God-of-Hacker/uC_Board/BOM/materialliste_microcontroller_board.xlsx

Sheet: Stückliste
Bemerkung | Pos | Bezug | Stk/Board | Bezeichnung | Typ/Wert | Gehäuse | Lieferant | Artikel-Nr | Link | Preis/Stk | Preis/Board | Stk für 35 | Preis für 35 | Status (ok) | Bestand (17.09.2021)
 |  |  | 1 | Schmitt_Tirgger | Logic-IC SO-14, 74HC14D, NXP | SO-14 | mouser | 771-74HC14D-Q100 |  | 0.320 | 0.32 | 35 | 11.20 |  | 34
 |  |  | 1 | Mikrocontroller | ATMEGA2560-16AU | TQFP-100 | digikey | ATMEGA2560-16AU-ND |  | 16.570 | 16.57 | 35 | 579.95 |  | 10
 |  |  | 1 | 74HC138 3 to 8 Decoder | Texas | TSSOP-16 | Mouser | 771-74HC138D-Q100 |  | 0.455 | 0.46 | 35 | 15.93 |  | 35
 |  |  | 1 | Induktivität | 10uH | 1206 | Mouser | 815-AIML-1206-100KT |  | 0.071 | 0.07 | 35 | 2.48 |  | 45
 |  |  | 1 | Quarz | 16MHz | HC49 | Mouser | 695-HCM49-16MABKUT |  | 0.460 | 0.46 | 35 | 16.10 |  | 37
 |  |  | 1 | LCD 4x40 Zeichen | EADIP203-4 |  | Mouser | 790-EADIP203J-4NLW |  | 32.830 | 32.83 | 35 | 1149.05 |  | 36
 |  |  | 1 | USB-C Kabel | Red, 1m |  | AliExpress |  | https://www.aliexpress.com/item/33002369577.html?spm=a2g0o.cart.0.0.38133c002f24TT&mp=1 | 1.720 | 1.72 | 35 | 60.20 |  | 50
 |  |  | 1 | USB-C Buchse | 10 x USB-C, 6Pin |  | AliExpress |  | https://www.aliexpress.com/item/4000857925361.html | 1.299 | 1.30 | 35 | 45.47 |  | 82
 |  |  | 1 | J-Tag-Buchse | Header VERT 10POS 1.27MM |  | digikey | 1175-1627-ND | https://www.digikey.ch/product-detail/de/cnc-tech/3220-10-0100-00/1175-1627-ND/3883661?cur=CHF&lang=de | 0.530 | 0.53 | 35 | 18.55 |  | 128
 |  |  | 1 | Lichtsensor | SFH 5701 |  | Mouser | 720-SFH5701 |  | 0.615 | 0.61 | 35 | 21.52 |  | 39
 |  |  | 1 | LED Diffusor | Abdeckung RGB LED |  | Farnell | 1215771 |  | 2.240 | 2.24 | 35 | 78.40 |  | 31
 |  |  | 1 | Spannungsregler 3.3V | XC6220B331MR-G | SOT-25 | Farnell | 1830935 |  | 0.782 | 0.78 | 35 | 27.37 |  | 12
 |  |  | 1 | Potentiometer | 3314G-1-252E / 2k5 | 3314G | Farnell | 2328470 |  | 0.934 | 0.93 | 35 | 32.69 |  | 43
nicht bestücken |  |  | 0 | Anschlussblock Phönix | 2Pol | 3.81mm | Farnell | 3704725 |  | 0.702 |  | 0 |  |  | ok
nicht bestücken |  |  | 0 | Schraub-Steckklemme Phönix | 2Pol | 3.81mm | Farnell | 3704907 |  | 2.600 |  | 0 |  |  | ok
 |  |  | 1 | 2x7 Stiftwanne 2514 | 3M | 2,54mm | Mouser | 517-30314-6002 |  | 1.210 | 1.21 | 35 | 42.35 |  | 42
 |  |  | 1 | Jumper | Jumper | 2.54mm | Mouser | 571-1-881545-4 |  | 0.050 | 0.05 | 35 | 1.75 |  | 460
 |  |  | 1 | LED | Grün | 1206 | Mouser | 604-APL3015CGCK-F01 |  | 0.130 | 0.13 | 35 | 4.55 |  | 41
 |  |  | 1 | Potentiometer | 50k |  | Mouser | 81-PVG3G503C01R00 |  | 1.620 | 1.62 | 35 | 56.70 |  | 3
 |  |  | 1 | Quarz | 32.768kHz | 3.2x8.3mm | Mouser | 815-AB38T-32.768KHZ |  | 0.156 | 0.16 | 35 | 5.46 |  | 52
 |  |  | 1 | Temperatursensor LM35DZ | TO-92 | 1,27mm | Mouser | 926-LM35DZ/NOPB |  | 0.749 | 0.75 | 35 | 26.21 |  | 24
 |  |  | 1 | LED | RGB | PLCC6 | Farnell | LEDCLX6E-FKC-CH1M1D1BB7C3D3 |  | 0.364 | 0.36 | 35 | 12.74 |  | 56
 |  |  | 1 | Joystick | Yellow (new) version |  | AliExpress |  | https://www.aliexpress.com/item/32641145656.html?spm=a2g0s.9042311.0.0.1a2c4c4dHblPEt | 1.760 | 1.76 | 35 | 61.60 |  | 14
 |  |  | 2 | Sicherung | ERB-RG2R00V | 1206 | Mouser | 667-ERB-RG2R00V |  | 0.475 | 0.95 | 70 | 33.25 |  | 54
 |  |  | 2 | 9P Header für LCD Display | 1x9 Pin SMD | 2mm | Mouser | 200-MMS10902FSV |  | 2.100 | 4.20 | 70 | 147.00 |  | 23
 |  |  | 3 | 2x5 Stiftwanne 2510 | 3M | 2,54mm | Mouser | 517-30310-6002 |  | 0.619 | 1.86 | 105 | 65.00 |  | 51
 |  |  | 2 | Potentiometer | 10kOhm | PTV09A | Mouser | 652-PTV09A-4020UB103 |  | 0.720 | 1.44 | 70 | 50.40 |  | 63
 |  |  | 2 | Widerstand | 10kΩ | 0805 | Mouser | 279-CRG0805F10K/10 |  | 0.027 | 0.05 | 70 | 1.89 |  | 830
 |  |  | 2 | Widerstand | 2kΩ | 0805 | Mouser | 652-CR0805JW-202ELF |  | 0.031 | 0.06 | 70 | 2.17 |  | 104
 |  |  | 2 | Keramikkondensator | 12pF 50V | 0805 | Mouser | 77-VJ0805A120GXAPBC |  | 0.015 | 0.03 | 70 | 1.05 |  | 39
 |  |  | 2 | Keramikkondensator | 18pF 25V | 0805 | Mouser | 77-VJ0805A180GXXCBC |  | 0.029 | 0.06 | 70 | 2.03 |  | 59
 |  |  | 2 | Hallsensor SS39E | Honeywell | SOT-23 | Mouser | 785-SS39ET |  | 1.210 | 2.42 | 70 | 84.70 |  | 30
 |  |  | 3 | Elektrolytkondensator | 100uF 16V | 6.3 x 5.4 | Mouser | 710-865230245004 |  | 0.223 | 0.67 | 105 | 23.42 |  | 98
 |  |  | 3 | Widerstand | 1kΩ | 0805 | Mouser | 667-ERJ-UP6F1001V |  | 0.010 | 0.03 | 105 | 1.05 |  | 870
 |  |  | 3 | Keramikkondensator | 1uF 50V | 0805 | Mouser | 80-C0805X105K5RAUTO |  | 0.040 | 0.12 | 105 | 4.20 |  | 92
 |  |  | 4 | Gummifuss transparent VPE20 | 20er Packung | 9,5x3,8mm | Distrelec | 300-97-569 |  | 0.105 | 0.42 | 140 | 14.70 |  | 200
 |  |  | 4 | Taster | FSM4JSMA | 5mm | Farnell | 3801305 |  | 0.128 | 0.51 | 140 | 17.92 |  | 124
 |  |  | 4 | Stiftleiste | 1x36 Breakaway | 2.54mm | Mouser | 538-22-28-4360 |  | 0.045 | 0.18 | 140 | 6.30 |  | 570
 |  |  | 20 | FET N-Kanal 30V, 7.6A, 17mΩ | PMV20EN | SOT-23 | Mouser | 621-DMG3406L-13 |  | 0.088 | 1.76 | 700 | 61.60 |  | 390
 |  |  | 8 | FET P-Kanal 20V, 5.6A, 27mΩ | PMV27UPER | SOT-23 | Mouser | 771-PMV27UPER |  | 0.138 | 1.10 | 280 | 38.64 |  | 270
 |  |  | 8 | Schalter | 10 x 5mm Miniature |  | AliExpress |  | https://www.aliexpress.com/item/1887673102.html?spm=a2g0o.cart.0.0.38133c002f24TT&mp=1 | 0.648 | 5.18 | 280 | 181.44 |  | 230
 |  |  | 6 | Widerstand | 100kΩ | 0805 | Mouser | 652-CHV0805AFX1003LF |  | 0.010 | 0.06 | 210 | 2.10 |  | 450
 |  |  | 16 | Keramikkondensator | 100nF 50V | 0805 | Mouser | 80-C0805R104J5RACTU |  | 0.017 | 0.27 | 560 | 9.52 |  | 460
 |  |  | 16 | LED | Blau | 1206 | Mouser | 604-APT3216QBC/D |  | 0.156 | 2.50 | 560 | 87.36 |  | 250
 |  |  | 20 | Widerstand | 150Ω | 0805 | Mouser | 755-KTR10EZPJ151 |  | 0.011 | 0.22 | 700 | 7.70 |  | 390
Nicht Bestellen Klassensatz |  |  | 1 | Programmer | Atmel-Ice-Pcba | none | Farnell | 2407171 | https://ch.farnell.com/microchip/atatmel-ice-pcba/debugger-atmel-arm-avr-pcba-kit/dp/2407171 | 55.640 | 55.64 | 35 | 1947.40 |  | ok
Nicht Bestellen Klassensatz |  |  | 2 | Jtag stecker | CONN SOCKET 10POS IDC GOLD |  | digikey | 3230-10-0102-00 | https://www.digikey.ch/product-detail/de/3230-10-0102-00/3230-10-0102-00-ND/3883464/?itemSeq=343224426 | 0.690 | 1.38 | 70 | 48.30 |  | ok
Nicht Bestellen Klassensatz |  |  | 1 | Jtag Kabel ca 10 cm | FLAT RBN CBL GRAY 10 COND 100' |  | digikey | CN211GR-100-ND | https://www.digikey.ch/products/de?keywords=cn211gr-100 | 0.107 | 0.11 | 35 | 3.75 |  | ok
Nicht Bestellen Klassensatz |  |  | 1 | Micro-USB für Jtag | RND 765-00054 - USB-A Micro-B |  | Distrelec | 301-25-772 | https://www.distrelec.ch/de/usb-anschluss-auf-usb-micro-anschlusskabel-900mm-schwarz-rnd-connect-rnd-765-00054/p/30125772 | 1.240 | 1.24 | 35 | 43.40 |  | ok
 |  |  | 0.5 | Linieal Footprints… | PCB-RULER-ND |  | digikey |  |  |  |  | 17.5 |  |  | 0

Sheet: Anzahl & Preis
Anzahl Boards: | 35
Preis ein Board: | 147.33
Preis 35 Boards: | 5156.55

Sheet: Altes
Bemerkung | Pos | Bezug | Stk/Board | Bezeichnung | Typ/Wert | Gehäuse | Lieferant | Artikel-Nr | Link | Preis/Stk | Preis/Board | Stk für 35 | Preis für 35 | Status (ok)
nicht bestellen |  |  | 0 | Sicherung | MC12CT 002 / 2,0A | 1206 | Farnell | 1841062 |  | 0.226 |  | 0
nicht bestellen |  |  | 0 | 9P Header für LCD Display | 1x9 Pin SMD | 2mm | Mouser | 517-953109-2000-AR-PR |  | 2.510 |  | 0
Nicht bestücken |  |  | 0 | MICRO USB 2.0 BUCHSE | MOLEX 47589-0001 | TYP AB | Farnell | 1568023 |  | 0.662 |  | 0
nicht bestellen |  |  | 0 | Speisgerät 5V Micro USB | 5V / 2.5A 1.5m Kabel |  | Farnell | 2520785 |  | 9.330 |  | 0
nicht bestücken |  |  | 0 | DIP Switch 8x, 21.2x6.2 | 8 fach DIP Switch, 2.54mm | DIP-16 | Mouser | 642-DMR08T |  | 1.020 |  | 0
nicht bestellen |  |  | 0 | JTAG Stiftwanne | 10pol. 2x5 pin | 1.27mm | Mouser | 855-M50-3500542 |  | 0.895 |  | 0
nicht Bestellen |  |  | 0 | XY Joystick |  |  |  |  | www.parallax.com/product/27800 | 6.500 |  | 0
nicht Bestellen |  |  | 0 | LED | red | 1206 | Mouser | 604-APT3216SRCPRV |  | 0.075 |  | 0
nicht Bestellen |  |  | 0 | Schieberegister |  | So-16 | Mouser | 771-HC165D652 |  | 0.194 |  | 0
nicht Bestellen |  |  | 0 | Weisse LED | 150mcd, 3.3V, 20mA | 1206 | Distrelec | 634021 |  | 0.368 |  | 0
nicht Bestellen |  |  | 0 | DC/DCKonverter 5VDC 1A, Traco Power | TSR 1-2450 |  | Distrelec | 361662 |  | 5.500 |  | 0
- |  |  | 1 | Quarz | 16MHz | HC49 | Mouser | 520-CSM1600-20-X |  | 0.295 | 0.29 | 35 | 10.32
- |  |  | 3 | Elektrolytkondensator | 100uF 35V | 6.3 x 5.4 | Mouser | 647-UWT1V101MCL1S |  | 0.125 | 0.38 | 105 | 13.12 | 20, 150 bestellt
- |  |  | 20 | Widerstand | 150Ω | 1206 | Mouser | 71-CRCW1206150RFKEB |  | 0.010 | 0.20 | 700 | 7.00
- |  |  | 1 | Lichtsensor | ALS-PT17-51C/L177/TR8 |  | Distrelec | 632917 |  | 0.879 | 0.88 | 35 | 30.77 | 20, 50 bestellt
- |  |  | 4 | FET N-Kanal 30V, 7.6A, 17mΩ | PMV20EN | SOT-23 | Mouser | 771-PMV20ENR |  | 0.108 | 0.43 | 140 | 15.12
- |  |  | 1 | Mikrocontroller | ATMEGA2560-16AU | TQFP-100 | Mouser | 556-ATMEGA2560-16AU |  | 16.570 | 16.57 | 35 | 579.95
- |  |  | 1 | Schmitt_Tirgger | Logic-IC SO-14, 74HC14D, NXP | SO-14 | Distrelec | 17390099 |  | 0.320 | 0.32 | 35 | 11.20 | 10, 50 bestellt
- |  |  | 1 | Potentiometer | 3314G-1-503E / 50k | 3314G | Mouser | 652-3314G-1-503E |  | 1.620 | 1.62 | 35 | 56.70 | 20, 50 bestellt
 |  |  | 1 | LED | RGB | PLCC6 | Mouser | 941-X6AFKBCJNNRFJ7A3 |  | 0.364 | 0.36 | 35 | 12.74 |  | 56

Sheet: Halbleiterbezug
Stk/Board | Bezeichnung | Typ/Wert | Name 1 | Name 2 | Name 3 | Name 4 | Name 5 | Name 6 | Name 7 | Name 8 | Name 9 | Name 10 | Name 11 | Name 12 | Name 13 | Name 14 | Name 15 | Name 16 | Name 17 | Name 18
1 | Schmitt_Tirgger | Logic-IC SO-14, 74HC14D, NXP
1 | Mikrocontroller | ATMEGA2560-16AU
1 | 74HC138 3 to 8 Decoder | Texas
1 | Quarz | 16MHz
1 | LCD 4x40 Zeichen | EADIP203-4
1 | Lichtsensor | SFH 5701
1 | Spannungsregler 3.3V | XC6220B331MR-G
1 | LED | Grün
1 | Quarz | 32.768kHz
1 | Temperatursensor LM35DZ | TO-92
1 | LED | RGB
2 | Hallsensor SS39E | Honeywell
20 | FET N-Kanal 30V, 7.6A, 17mΩ | PMV20EN
8 | FET P-Kanal 20V, 5.6A, 27mΩ | PMV27UPER
16 | LED | Blau
1 | PCB
58 | Total |  | 0 | 0 | 0 | 0 | 0 | 0 | 0 | 0 | 0 | 0 | 0 | 0 | 0 | 0 | 0 | 0 | 0 | 0
Zeit Board 1
Zeit Board 1
Zeit Board 1 | Total |  | 0 | 0 | 0 | 0 | 0 | 0 | 0 | 0 | 0 | 0 | 0 | 0 | 0 | 0 | 0 | 0 | 0 | 0
Zeit Board 2
Zeit Board 2
Zeit Board 2 | Total |  | 0 | 0 | 0 | 0 | 0 | 0 | 0 | 0 | 0 | 0 | 0 | 0 | 0 | 0 | 0 | 0 | 0 | 0
