God-of-Hacker/uC_Board/Hardware/Vorlage ATmega2560-16AU/Vorlage ATmega2560-16AU.brd

## EAGLE design Hardware/Vorlage ATmega2560-16AU/Vorlage ATmega2560-16AU.brd (2021-11-11)

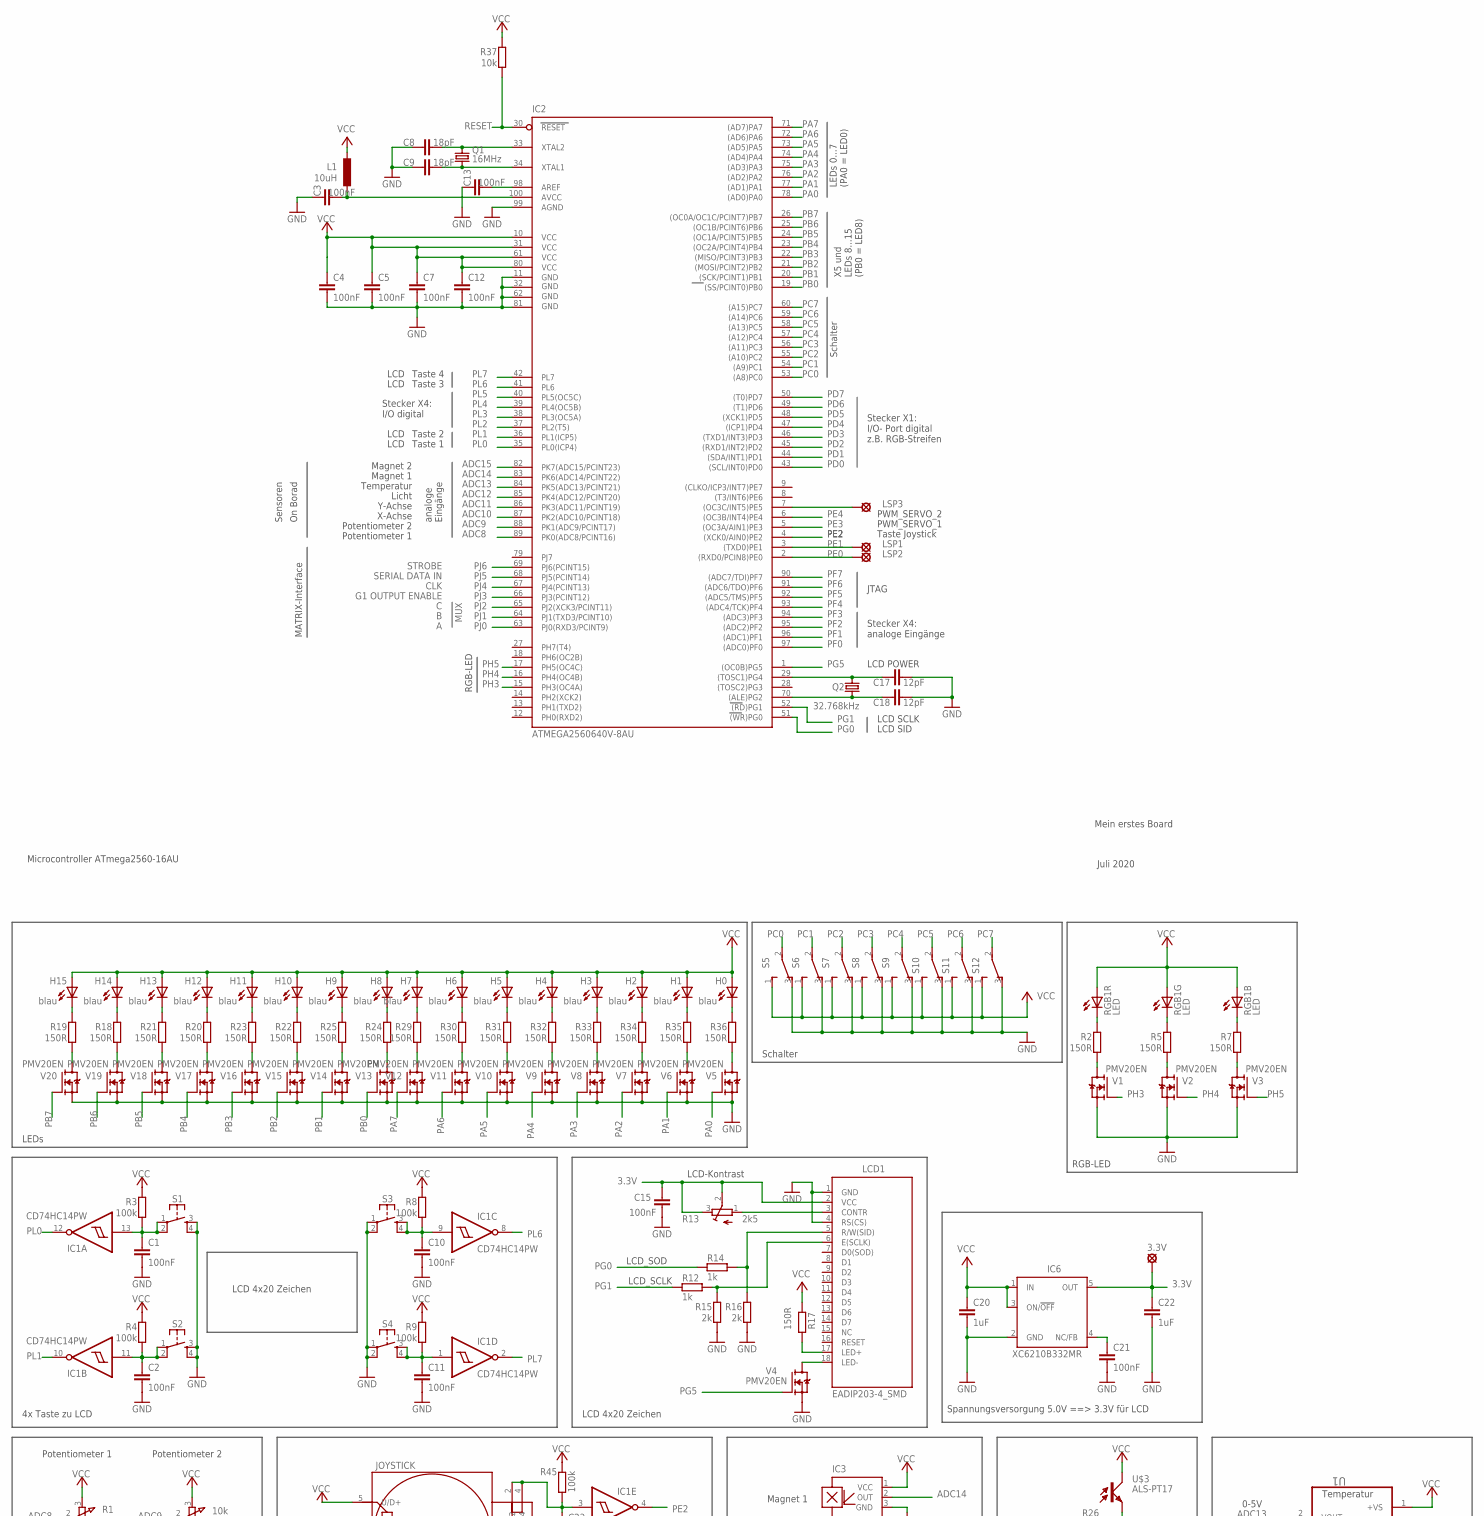
[picture p1: schematic Vorlage ATmega2560-16AU.sch, part in row 1, column 1]

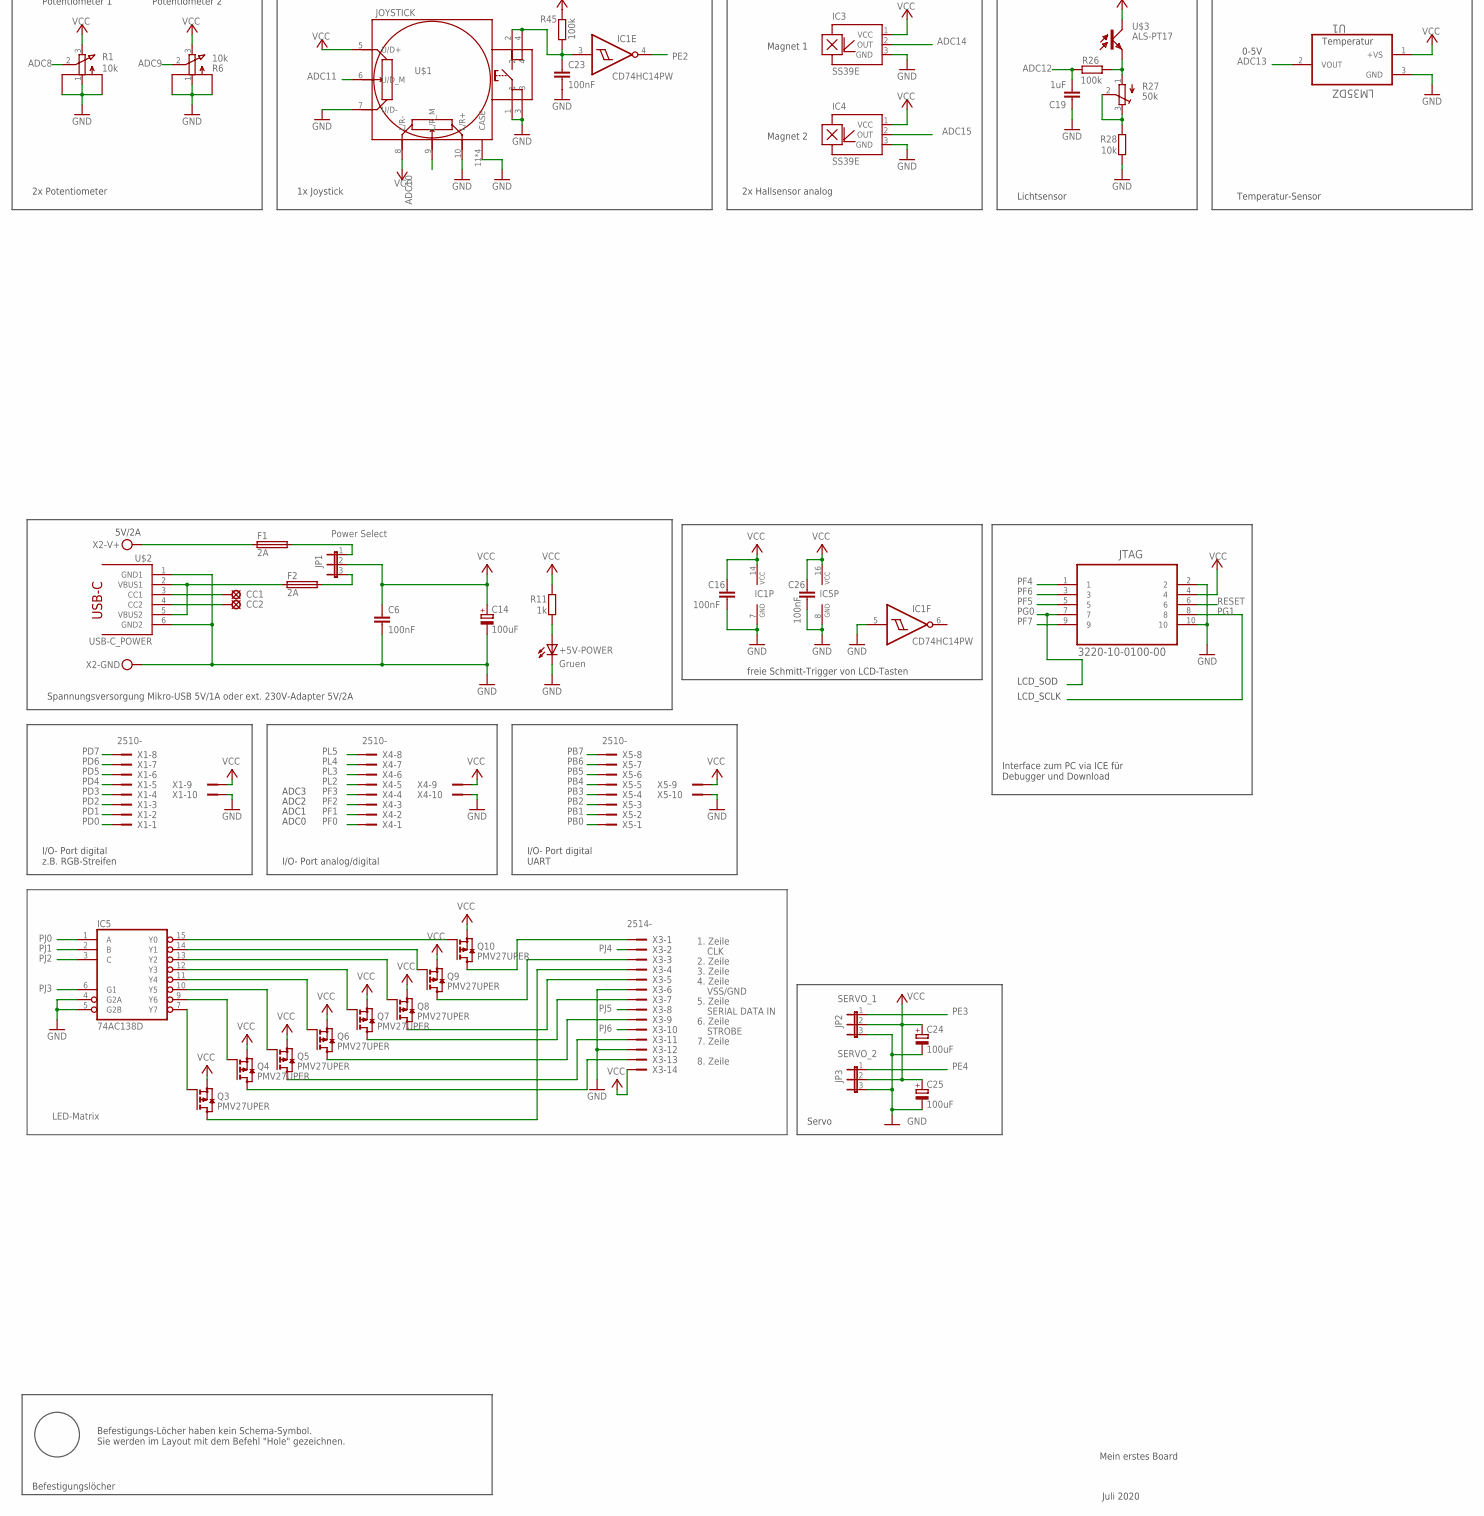
[picture p2: schematic Vorlage ATmega2560-16AU.sch, part in row 2, column 1]

Parts:
3.3V: 3.3V; LSP11
+5V-POWER: Gruen; CHIPLED_1206
C1, C2, C3, C4, C5, C7, C10, C11, C12, C13, C21, C23: 100nF; C0805
C6, C15, C16, C26: 100nF; C1206
C8, C9: 18pF; C0805K
C14, C24, C25: 100uF; UD-6,3X5,8_NICHICON
C17, C18: 12pF; C0805K
C19, C20, C22: 1uF; C0805
CC1, CC2: LSP11
F1, F2: 2A; F1206
H0, H1, H2, H3, H4, H5, H6, H7, H8, H9, H10, H11, H12, H13, H14, H15: blau; CHIPLED_1206
IC1: CD74HC14PW; SO14
IC2: ATMEGA2560640V-8AU; TQFP100
IC3, IC4: SS39E; SOT23-W
IC5: 74AC138D; SO16
IC6: XC6210B332MR; SOT23-DBV
JP1: Power Select; JP2
JP2: SERVO_1; JP2
JP3: SERVO_2; JP2
JTAG: 3220-10-0100-00; SAMTEC_FTS-105-01-L-D
L1: 10uH; L2825P
LCD1: EADIP203-4_SMD; EADIP203-4SMD
LSP1, LSP2, LSP3: LSP11
Q1: 16MHz; HC49UP
Q2: 32.768kHz; TC38H
Q3, Q4, Q5, Q6, Q7, Q8, Q9, Q10: PMV27UPER; SOT23
R1, R6: 10k; EVUF
R2, R5, R7, R18, R19, R20, R21, R22, R23, R24, R25, R29, R30, R31, R32, R33, R34, R35, R36: 150R; R0805
R3, R4, R8, R9, R26, R45: 100k; R0805
R11, R12, R14: 1k; R0805
R13: 2k5; 3223G
R15, R16: 2k; R0805
R17: 150R; R1206
R27: 50k; 3223G
R28, R37: 10k; R0805
RGB1: LED; LED_MIT_DIFUSOR
S1, S2, S3, S4: TS42_4PAD
S5, S6, S7, S8, S9, S10, S11, S12: TL36POSPDT_5MM; SPDT_5MM
U1: LM35DZ; TO127P254X495-3P
U$1: JOYSTICK; RKJXV1224005
U$2: USB-C_POWER; USB-C
U$3: ALS-PT17; SOD232-W
V1, V2, V3, V4, V5, V6, V7, V8, V9, V10, V11, V12, V13, V14, V15, V16, V17, V18, V19, V20: PMV20EN; SOT23
X1, X4, X5: 2510-; PAK100/2500-10
X2: +5V; MKDSN1,5/2-5,08
X3: 2514-; PAK100/2500-14

Connections:
3.3V: 3.3V.MP, C15.1, C22.1, IC6.5 (OUT), LCD1.2 (VCC), R13.2 (S), R13.3 (E)
ADC8: IC2.89 (PK0(ADC8/PCINT16)), R1.2 (S)
ADC9: IC2.88 (PK1(ADC9/PCINT17)), R6.2 (S)
ADC10: IC2.87 (PK2(ADC10/PCINT18)), U$1.9 (L/R_M)
ADC11: IC2.86 (PK3(ADC11/PCINT19)), U$1.6 (U/D_M)
ADC12: C19.2, IC2.85 (PK4(ADC12/PCINT20)), R26.2
ADC13: IC2.84 (PK5(ADC13/PCINT21)), U1.2 (VOUT)
ADC14: IC2.83 (PK6(ADC14/PCINT22)), IC3.2 (OUT)
ADC15: IC2.82 (PK7(ADC15/PCINT23)), IC4.2 (OUT)
GND: +5V-POWER.C, C1.2, C2.2, C3.1, C4.2, C5.2, C6.2, C7.2, C8.1, C9.2, C10.2, C11.2, C12.2, C13.1, C14.-, C15.2, C16.2, C17.2, C18.2, C19.1, C20.2, C21.2, C22.2, C23.2, C24.-, C25.-, C26.2, IC1.5 (I), IC1.7 (GND), IC2.11 (GND), IC2.32 (GND1), IC2.62 (GND2), IC2.81 (GND3), IC2.99 (AGND), IC3.3 (GND), IC4.3 (GND), IC5.4 (G2A), IC5.5 (G2B), IC5.8 (GND), IC6.2 (GND), JP2.3, JP3.3, JTAG.2, JTAG.10, LCD1.1 (GND), LCD1.4 (RS(CS)), R1.1 (A), R1.M1, R1.M2, R6.1 (A), R6.M1, R6.M2, R15.1, R16.1, R28.1, S1.3, S1.4, S2.3, S2.4, S3.1, S3.2, S4.1, S4.2, S5.3 (O), S6.3 (O), S7.3 (O), S8.3 (O), S9.3 (O), S10.3 (O), S11.3 (O), S12.3 (O), U1.3 (GND), U$1.1, U$1.3, U$1.7 (U/D-), U$1.10 (L/R+), U$1.11 (CASE), U$1.12 (CASE), U$1.15 (CASE), U$1.16 (CASE), U$2.1 (GND1), U$2.6 (GND2), V1.2 (S), V2.2 (S), V3.2 (S), V4.2 (S), V5.2 (S), V6.2 (S), V7.2 (S), V8.2 (S), V9.2 (S), V10.2 (S), V11.2 (S), V12.2 (S), V13.2 (S), V14.2 (S), V15.2 (S), V16.2 (S), V17.2 (S), V18.2 (S), V19.2 (S), V20.2 (S), X1.10, X2.1.1, X2.1.2, X3.6, X3.12, X4.10, X5.10
H1: H15.C, R19.2
H7: H7.C, R29.2
unnamed: R7.2, RGB1.1 (C)
unnamed: R5.2, RGB1.2 (C)
unnamed: F1.2, JP1.1
unnamed: F2.2, JP1.3
unnamed: R36.1, V5.3 (D)
unnamed: R35.1, V6.3 (D)
unnamed: R34.1, V7.3 (D)
unnamed: CC1.MP, U$2.3 (CC1)
unnamed: C23.1, IC1.3 (I), R45.2, U$1.2, U$1.4
unnamed: CC2.MP, U$2.4 (CC2)
unnamed: R2.2, RGB1.3 (C)
unnamed: LCD1.18 (LED-), V4.3 (D)
unnamed: R33.1, V8.3 (D)
unnamed: R32.1, V9.3 (D)
unnamed: R31.1, V10.3 (D)
unnamed: R30.1, V11.3 (D)
unnamed: R29.1, V12.3 (D)
unnamed: IC2.7 ((OC3C/INT5)PE5), LSP3.MP
unnamed: R26.1, R27.1 (A), U$3.E
unnamed: R27.2 (S), R27.3 (E), R28.2
unnamed: C1.1, IC1.13 (I), R3.2, S1.1, S1.2
unnamed: C2.1, IC1.11 (I), R4.2, S2.1, S2.2
unnamed: C11.1, IC1.1 (I), R9.2, S4.3, S4.4
unnamed: C10.1, IC1.9 (I), R8.2, S3.3, S3.4
unnamed: C9.1, IC2.34 (XTAL1), Q1.1
unnamed: C3.2, IC2.100 (AVCC), L1.2
unnamed: R2.1, V1.3 (D)
unnamed: R5.1, V2.3 (D)
unnamed: R7.1, V3.3 (D)
unnamed: C13.2, IC2.98 (AREF)
unnamed: F2.1, U$2.2 (VBUS1), U$2.5 (VBUS2)
unnamed: C17.1, IC2.29 ((TOSC1)PG4), Q2.1
unnamed: H6.C, R30.2
unnamed: LCD1.3 (CONTR), R13.1 (A)
unnamed: C18.1, IC2.70 ((ALE)PG2), Q2.2
unnamed: C8.2, IC2.33 (XTAL2), Q1.2
unnamed: LCD1.6 (E(SCLK)), R12.1, R15.2
unnamed: LCD1.5 (R/W(SID)), R14.1, R16.2
unnamed: H14.C, R18.2
unnamed: H12.C, R20.2
unnamed: H2.C, R34.2
unnamed: H4.C, R32.2
unnamed: H5.C, R31.2
unnamed: H13.C, R21.2
unnamed: H10.C, R22.2
unnamed: H3.C, R33.2
unnamed: H11.C, R23.2
unnamed: H8.C, R24.2
unnamed: H0.C, R36.2
unnamed: H1.C, R35.2
unnamed: H9.C, R25.2
unnamed: +5V-POWER.A, R11.2
unnamed: R24.1, V13.3 (D)
unnamed: R25.1, V14.3 (D)
unnamed: R22.1, V15.3 (D)
unnamed: R23.1, V16.3 (D)
unnamed: R20.1, V17.3 (D)
unnamed: R21.1, V18.3 (D)
unnamed: R18.1, V19.3 (D)
unnamed: R19.1, V20.3 (D)
unnamed: C21.1, IC6.4 (NC/FB)
unnamed: F1.1, X2.2.1, X2.2.2
unnamed: LCD1.17 (LED+), R17.1
unnamed: IC5.15 (Y0), Q10.1 (G)
unnamed: Q10.3 (D), X3.1
unnamed: IC5.14 (Y1), Q9.1 (G)
unnamed: IC5.13 (Y2), Q8.1 (G)
unnamed: IC5.12 (Y3), Q7.1 (G)
unnamed: IC5.11 (Y4), Q6.1 (G)
unnamed: IC5.10 (Y5), Q5.1 (G)
unnamed: IC5.9 (Y6), Q4.1 (G)
unnamed: IC5.7 (Y7), Q3.1 (G)
unnamed: Q9.3 (D), X3.3
unnamed: Q3.3 (D), X3.4
unnamed: Q8.3 (D), X3.5
unnamed: Q7.3 (D), X3.7
unnamed: Q6.3 (D), X3.9
unnamed: Q5.3 (D), X3.11
unnamed: Q4.3 (D), X3.13
PA0: IC2.78 ((AD0)PA0), V5.1 (G)
PA1: IC2.77 ((AD1)PA1), V6.1 (G)
PA2: IC2.76 ((AD2)PA2), V7.1 (G)
PA3: IC2.75 ((AD3)PA3), V8.1 (G)
PA4: IC2.74 ((AD4)PA4), V9.1 (G)
PA5: IC2.73 ((AD5)PA5), V10.1 (G)
PA6: IC2.72 ((AD6)PA6), V11.1 (G)
PA7: IC2.71 ((AD7)PA7), V12.1 (G)
PB0: IC2.19 ((SS/PCINT0)PB0), V13.1 (G), X5.1
PB1: IC2.20 ((SCK/PCINT1)PB1), V14.1 (G), X5.2
PB2: IC2.21 ((MOSI/PCINT2)PB2), V15.1 (G), X5.3
PB3: IC2.22 ((MISO/PCINT3)PB3), V16.1 (G), X5.4
PB4: IC2.23 ((OC2A/PCINT4)PB4), V17.1 (G), X5.5
PB5: IC2.24 ((OC1A/PCINT5)PB5), V18.1 (G), X5.6
PB6: IC2.25 ((OC1B/PCINT6)PB6), V19.1 (G), X5.7
PB7: IC2.26 ((OC0A/OC1C/PCINT7)PB7), V20.1 (G), X5.8
PC0: IC2.53 ((A8)PC0), S5.2
PC1: IC2.54 ((A9)PC1), S6.2
PC2: IC2.55 ((A10)PC2), S7.2
PC3: IC2.56 ((A11)PC3), S8.2
PC4: IC2.57 ((A12)PC4), S9.2
PC5: IC2.58 ((A13)PC5), S10.2
PC6: IC2.59 ((A14)PC6), S11.2
PC7: IC2.60 ((A15)PC7), S12.2
PD0: IC2.43 ((SCL/INT0)PD0), X1.1
PD1: IC2.44 ((SDA/INT1)PD1), X1.2
PD2: IC2.45 ((RXD1/INT2)PD2), X1.3
PD3: IC2.46 ((TXD1/INT3)PD3), X1.4
PD4: IC2.47 ((ICP1)PD4), X1.5
PD5: IC2.48 ((XCK1)PD5), X1.6
PD6: IC2.49 ((T1)PD6), X1.7
PD7: IC2.50 ((T0)PD7), X1.8
PE0: IC2.2 ((RXD0/PCIN8)PE0), LSP2.MP
PE1: IC2.3 ((TXD0)PE1), LSP1.MP
PE2: IC1.4 (O), IC2.4 ((XCK0/AIN0)PE2)
PE3: IC2.5 ((OC3A/AIN1)PE3), JP2.1
PE4: IC2.6 ((OC3B/INT4)PE4), JP3.1
PF0: IC2.97 ((ADC0)PF0), X4.1
PF1: IC2.96 ((ADC1)PF1), X4.2
PF2: IC2.95 ((ADC2)PF2), X4.3
PF3: IC2.94 ((ADC3)PF3), X4.4
PF4: IC2.93 ((ADC4/TCK)PF4), JTAG.1
PF5: IC2.92 ((ADC5/TMS)PF5), JTAG.5
PF6: IC2.91 ((ADC6/TDO)PF6), JTAG.3
PF7: IC2.90 ((ADC7/TDI)PF7), JTAG.9
PG0: IC2.51 ((WR)PG0), JTAG.7, R14.2
PG1: IC2.52 ((RD)PG1), JTAG.8, R12.2
PG5: IC2.1 ((OC0B)PG5), V4.1 (G)
PH3: IC2.15 (PH3(OC4A)), V1.1 (G)
PH4: IC2.16 (PH4(OC4B)), V2.1 (G)
PH5: IC2.17 (PH5(OC4C)), V3.1 (G)
PJ0: IC2.63 (PJ0(RXD3/PCINT9)), IC5.1 (A)
PJ1: IC2.64 (PJ1(TXD3/PCINT10)), IC5.2 (B)
PJ2: IC2.65 (PJ2(XCK3/PCINT11)), IC5.3 (C)
PJ3: IC2.66 (PJ3(PCINT12)), IC5.6 (G1)
PJ4: IC2.67 (PJ4(PCINT13)), X3.2
PJ5: IC2.68 (PJ5(PCINT14)), X3.8
PJ6: IC2.69 (PJ6(PCINT15)), X3.10
PL0: IC1.12 (O), IC2.35 (PL0(ICP4))
PL1: IC1.10 (O), IC2.36 (PL1(ICP5))
PL2: IC2.37 (PL2(T5)), X4.5
PL3: IC2.38 (PL3(OC5A)), X4.6
PL4: IC2.39 (PL4(OC5B)), X4.7
PL5: IC2.40 (PL5(OC5C)), X4.8
PL6: IC1.8 (O), IC2.41 (PL6)
PL7: IC1.2 (O), IC2.42 (PL7)
RESET: IC2.30 (RESET), JTAG.6, R37.1
VCC: C4.1, C5.1, C6.1, C7.1, C12.1, C14.+, C16.1, C20.1, C24.+, C25.+, C26.1, H0.A, H1.A, H2.A, H3.A, H4.A, H5.A, H6.A, H7.A, H8.A, H9.A, H10.A, H11.A, H12.A, H13.A, H14.A, H15.A, IC1.14 (VCC), IC2.10 (VCC), IC2.31 (VCC1), IC2.61 (VCC2), IC2.80 (VCC3), IC3.1 (VCC), IC4.1 (VCC), IC5.16 (VCC), IC6.1 (IN), IC6.3 (ON/!OFF), JP1.2, JP2.2, JP3.2, JTAG.4, L1.1, Q3.2 (S), Q4.2 (S), Q5.2 (S), Q6.2 (S), Q7.2 (S), Q8.2 (S), Q9.2 (S), Q10.2 (S), R1.3 (E), R3.1, R4.1, R6.3 (E), R8.1, R9.1, R11.1, R17.2, R37.2, R45.1, RGB1.4 (A), RGB1.5 (A), RGB1.6 (A), S5.1 (S), S6.1 (S), S7.1 (S), S8.1 (S), S9.1 (S), S10.1 (S), S11.1 (S), S12.1 (S), U1.1 (+VS), U$1.5 (U/D+), U$1.8 (L/R-), U$3.C, X1.9, X3.14, X4.9, X5.9

Notes on the sheet:
Microcontroller ATmega2560-16AU
LCD SID
LCD SCLK
Taste 1
Taste 2
Taste 3
Taste 4
LCD
LCD POWER
Mein erstes Board
Juli 2020
JTAG
analoge Eingänge
G1 OUTPUT ENABLE
MUX
CLK
SERIAL DATA IN
STROBE
Magnet 2
Magnet 1
Temperatur
Licht
Y-Achse
X-Achse
Potentiometer 2
Potentiometer 1
Stecker X1: I/O- Port digital z.B. RGB-Streifen
MATRIX-Interface
Sensoren
On Borad
Stecker X4: analoge Eingänge
Stecker X4: I/O digital
Taste Joystick
PWM_SERVO_1
PWM_SERVO_2
I/O- Port digital UART
LCD 4x20 Zeichen
Spannungsversorgung Mikro-USB 5V/1A oder ext. 230V-Adapter 5V/2A
Spannungsversorgung 5.0V ==> 3.3V für LCD
Interface zum PC via ICE für Debugger und Download
LCD-Kontrast
2x Potentiometer
Temperatur-Sensor
0-5V
Befestigungs-Löcher haben kein Schema-Symbol. Sie werden im Layout mit dem Befehl "Hole" gezeichnen.
Befestigungslöcher
Lichtsensor
4x Taste zu LCD
freie Schmitt-Trigger von LCD-Tasten
LED-Matrix
VSS/GND
1. Zeile
2. Zeile
3. Zeile
4. Zeile
6. Zeile
5. Zeile
7. Zeile
8. Zeile
1x Joystick
2x Hallsensor analog
I/O- Port digital z.B. RGB-Streifen
LCD_SOD
LCD_SCLK
I/O- Port analog/digital
ADC0
ADC1
ADC2
ADC3
5V/2A
Servo
RGB-LED
Schalter
LEDs
LEDs 0...7 (PA0 = LED0)
X5 und LEDs 8...15 (PB0 = LED8)

Board: 2 copper layers, 152 parts (0 on the bottom side), 159 nets, no tracks yet.
